lfiack/eurorack_nvlp_1u/README.md

# Eurorack NVLP 1U
Single Attack/Release envelope generator based on an STM32
