lfiack/eurorack_nvlp_1u/hardware/eurorack_nvlp_1u/eurorack_nvlp_1u.kicad_pcb

## KiCad design hardware/eurorack_nvlp_1u/eurorack_nvlp_1u.kicad_pcb (2022-10-28)

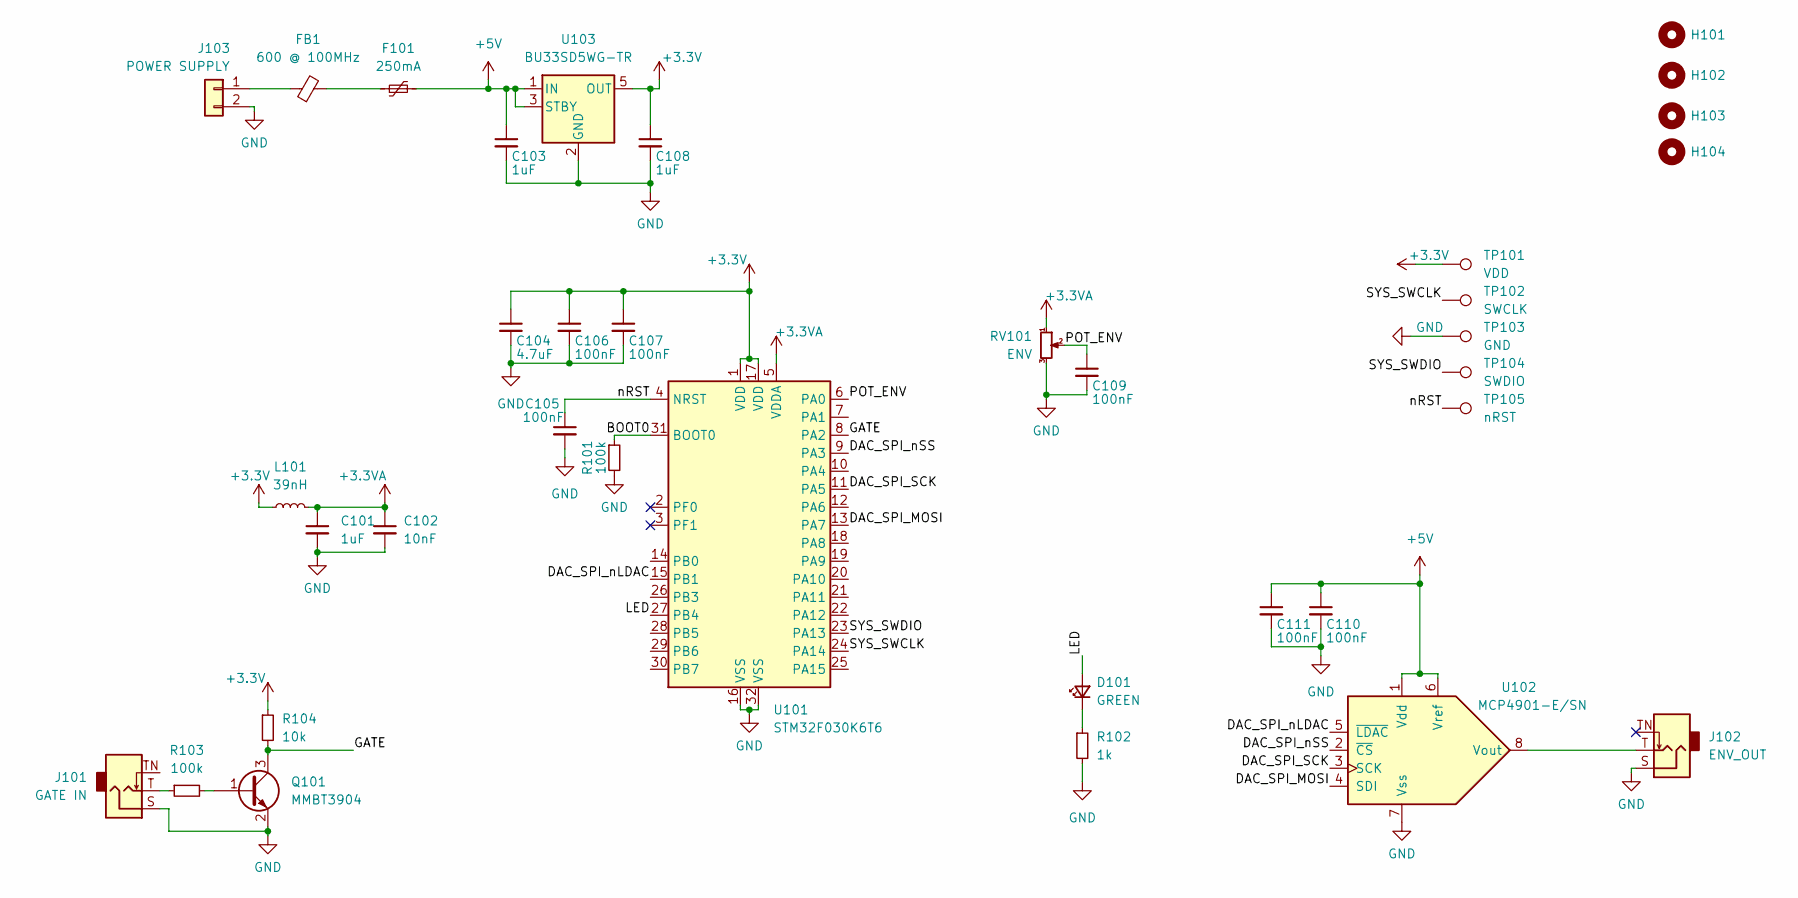
[picture p1: schematic eurorack_nvlp_1u.kicad_sch]

Parts:
C101, C103, C108: 1uF; C_0603_1608Metric
C102: 10nF; C_0603_1608Metric
C104: 4.7uF; C_0603_1608Metric
C105, C106, C107, C109, C110, C111: 100nF; C_0603_1608Metric
D101: GREEN; LED_0603_1608Metric
F101: 250mA; Fuse_1206_3216Metric; Farnell 2834880
FB1: 600 @ 100MHz; L_0805_2012Metric_Pad1.15x1.40mm_HandSolder; Farnell 2292460
H101, H102, H103, H104: MountingHole; MountingHole_3.2mm_M3
J101: GATE IN; Jack_3.5mm_QingPu_WQP-PJ398SM_Vertical_CircularHoles
J102: ENV_OUT; Jack_3.5mm_QingPu_WQP-PJ398SM_Vertical_CircularHoles
J103: POWER SUPPLY; JST_XH_B2B-XH-A_1x02_P2.50mm_Vertical
L101: 39nH; L_0603_1608Metric
Q101: MMBT3904; SOT-23
R101, R103: 100k; R_0603_1608Metric
R102: 1k; R_0603_1608Metric
R104: 10k; R_0603_1608Metric
RV101: ENV; Potentiometer_Alpha_RD901F-40-00D_Single_Vertical
TP101: VDD; TestPoint_Pad_D1.5mm
TP102: SWCLK; TestPoint_Pad_D1.5mm
TP103: GND; TestPoint_Pad_D1.5mm
TP104: SWDIO; TestPoint_Pad_D1.5mm
TP105: nRST; TestPoint_Pad_D1.5mm
U101: STM32F030K6T6; LQFP-32_7x7mm_P0.8mm
U102: MCP4901-E/SN; SOIC-8_3.9x4.9mm_P1.27mm
U103: BU33SD5WG-TR; SOT-23-5

Connections:
+3.3V: C104.1, C106.1, C107.1, C108.1, L101.1, R104.1, TP101.1, U101.1 (VDD), U101.17 (VDD), U103.5 (OUT)
+3.3VA: C101.1, C102.1, L101.2, RV101.1, U101.5 (VDDA)
+5V: C103.1, C110.1, C111.1, F101.2, U102.1 (Vdd), U102.6 (Vref), U103.1 (IN), U103.3 (STBY)
/BOOT0: R101.1, U101.31 (BOOT0)
/DAC_SPI_MOSI: U101.13 (PA7), U102.4 (SDI)
/DAC_SPI_SCK: U101.11 (PA5), U102.3 (SCK)
/DAC_SPI_nLDAC: U101.15 (PB1), U102.5 (~LDAC)
/DAC_SPI_nSS: U101.9 (PA3), U102.2 (~CS)
/GATE: Q101.3 (C), R104.2, U101.8 (PA2)
/LED: D101.2 (A), U101.27 (PB4)
/POT_ENV: C109.1, RV101.2, U101.6 (PA0)
/SYS_SWCLK: TP102.1, U101.24 (PA14)
/SYS_SWDIO: TP104.1, U101.23 (PA13)
/nRST: C105.1, TP105.1, U101.4 (NRST)
GND: C101.2, C102.2, C103.2, C104.2, C105.2, C106.2, C107.2, C108.2, C109.2, C110.2, C111.2, J101.S, J102.S, J103.2, Q101.2 (E), R101.2, R102.2, RV101.3, TP103.1, U101.16 (VSS), U101.32 (VSS), U102.7 (Vss), U103.2 (GND)
unnamed: D101.1 (K), R102.1
unnamed: F101.1, FB1.2
unnamed: J101.T, R103.1
unnamed: J102.T, U102.8 (Vout)
unnamed: FB1.1, J103.1
unnamed: Q101.1 (B), R103.2

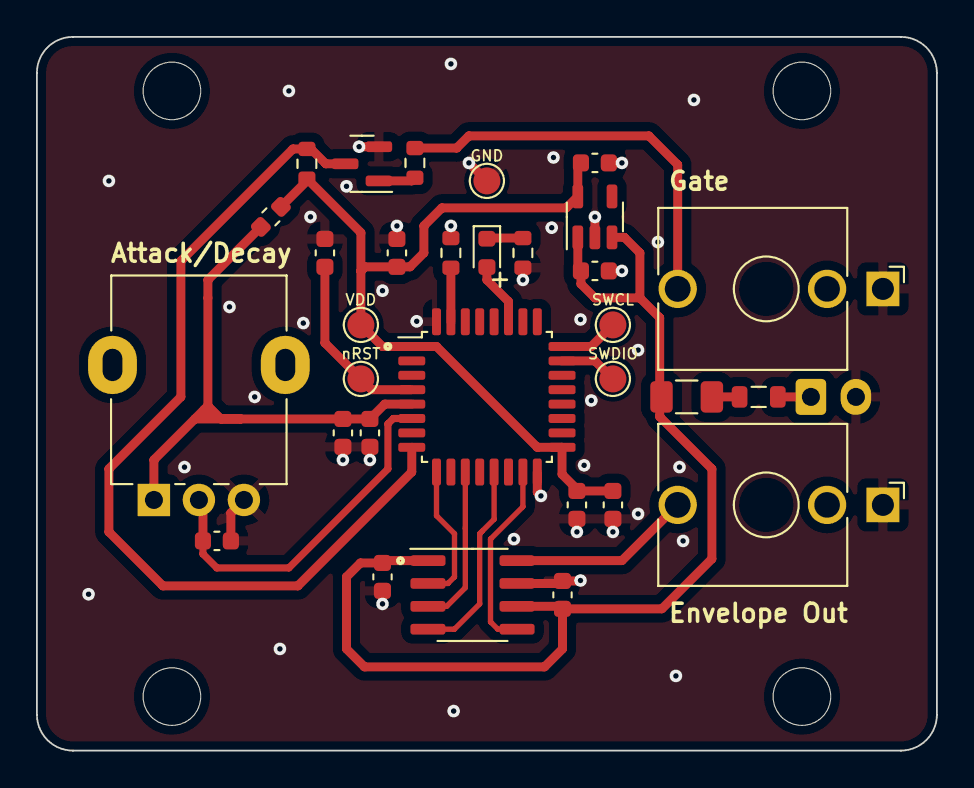
[picture p2: board eurorack_nvlp_1u.kicad_pcb from above]

Board: 2 copper layers, 50.0 x 39.6 mm, 36 parts (1 on the bottom side), 21 nets.
