lfiack/eurorack_nvlp_1u/firmware/Core/Src/main.c

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
/* Includes ------------------------------------------------------------------*/
#include "main.h"
#include "adc.h"
#include "spi.h"
#include "tim.h"
#include "gpio.h"

/* USER CODE BEGIN Includes */
#include "nvlp.h"
/* USER CODE END Includes */


/* USER CODE BEGIN PV */
h_nvlp_t h_nvlp;
nvlp_driver_t nvlp_driver;
/* USER CODE END PV */

void SystemClock_Config(void);
/* USER CODE BEGIN PFP */
uint32_t irq_counter = 0;
/* USER CODE END PFP */

/* USER CODE BEGIN 0 */
void HAL_ADC_ConvCpltCallback(ADC_HandleTypeDef* hadc)
{
  if (ADC1 == hadc->Instance)
  {
    nvlp_interrupt_callback(&h_nvlp);
    irq_counter++;
  }
}

uint8_t get_gate_pin(void)
{
  // if (GPIO_PIN_RESET == HAL_GPIO_ReadPin(GATE_GPIO_Port, GATE_Pin))
  // {
  //   return 0;
  // }
  // else
  // {
  //   return 1;
  // }

  if ((HAL_GetTick()%1000) == 0)
  {
    return 1;
  }
  else
  {
    return 0;
  }
}

uint16_t get_potentiometer(void)
{
  return (uint16_t) 65535 - HAL_ADC_GetValue(&hadc);
}

#define MCP49X1_UNBUFFERED 0
#define MCP49X1_BUFFERED 0x4000

#define MCP49X1_GAIN_0 0
#define MCP49X1_GAIN_1 0x2000

#define MCP49X1_SHDN 0
#define MCP49X1_ACTIVE 0x1000

void set_output(uint16_t value)
{
  //SPI 20MHz max (-> configured to 12MHz in CubeMX)
  //SPI supports mode 0,0 and 1,1 so CPOL=Low and CPHA=1 Edge I guess?
  //SPI is 16 bits
  //VREF in unbuffered mode (to be rail to rail 0->5V) (BUF = 0)
  //Gain is 1 (GA = 1)
  //Output activated (SHDN=1)
  //Value from bit 11 downto 0

  uint16_t command = (value >> 4) & 0x0FFF;
  command += (MCP49X1_UNBUFFERED | MCP49X1_GAIN_1 | MCP49X1_ACTIVE);

  uint8_t buffer[2] = {(command >> 8) & 0xFF, command & 0xFF};

  // Lights the LED with the full value
  __HAL_TIM_SET_COMPARE(&htim3, TIM_CHANNEL_1, value);

  HAL_GPIO_WritePin(DAC_SPI_nSS_GPIO_Port, DAC_SPI_nSS_Pin, GPIO_PIN_RESET);
  HAL_SPI_Transmit(&hspi1, buffer, 2, HAL_MAX_DELAY);
  HAL_GPIO_WritePin(DAC_SPI_nSS_GPIO_Port, DAC_SPI_nSS_Pin, GPIO_PIN_SET);
}

/* USER CODE END 0 */

/**
  * @brief  The application entry point.
  * @retval int
  */
int main(void)
{
  /* MCU Configuration--------------------------------------------------------*/

  /* Reset of all peripherals, Initializes the Flash interface and the Systick. */
  HAL_Init();

  /* Configure the system clock */
  SystemClock_Config();

  /* Initialize all configured peripherals */
  MX_GPIO_Init();
  MX_ADC_Init();
  MX_SPI1_Init();
  MX_TIM3_Init();
  MX_TIM1_Init();
  /* USER CODE BEGIN 2 */
  DBGMCU->APB2FZ |= DBGMCU_APB2_FZ_DBG_TIM1_STOP;

  HAL_ADCEx_Calibration_Start(&hadc);

  nvlp_driver.get_gate_pin = get_gate_pin;
  nvlp_driver.get_potentiometer = get_potentiometer;
  nvlp_driver.set_output = set_output;

  h_nvlp.driver = &nvlp_driver;

  h_nvlp.is_lfo = true;
  nvlp_init(&h_nvlp);

  HAL_TIM_PWM_Start(&htim3, TIM_CHANNEL_1);
  HAL_ADC_Start_IT(&hadc);
  HAL_TIM_Base_Start(&htim1);
  
  /* USER CODE END 2 */

  /* Infinite loop */
  /* USER CODE BEGIN WHILE */
  while (1)
  {
    /* USER CODE END WHILE */

    /* USER CODE BEGIN 3 */
  }
  /* USER CODE END 3 */
}

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
