lfiack/eurorack_nvlp_1u/firmware/Core/Inc/main.h

#define POT_ENV_Pin GPIO_PIN_0
#define POT_ENV_GPIO_Port GPIOA
#define GATE_Pin GPIO_PIN_2
#define GATE_GPIO_Port GPIOA
#define GATE_EXTI_IRQn EXTI2_3_IRQn
#define DAC_SPI_nSS_Pin GPIO_PIN_3
#define DAC_SPI_nSS_GPIO_Port GPIOA
#define DAC_SPI_SCK_Pin GPIO_PIN_5
#define DAC_SPI_SCK_GPIO_Port GPIOA
#define DAC_SPI_MOSI_Pin GPIO_PIN_7
#define DAC_SPI_MOSI_GPIO_Port GPIOA
#define DAC_SPI_nLDAC_Pin GPIO_PIN_1
#define DAC_SPI_nLDAC_GPIO_Port GPIOB
#define LED_Pin GPIO_PIN_4
#define LED_GPIO_Port GPIOB
