lfiack/eurorack_nvlp_1u/(commit log)

2022-10-24 Schematics + PCB
    [eurorack_nvlp_1u.kicad_pcb, eurorack_nvlp_1u.kicad_sch]
2022-10-24 small upgrades on the PCB
    [eurorack_nvlp_1u.kicad_pcb]
2022-10-28 fichiers de fab
    [eurorack_nvlp_1u-B_Cu.gbr, eurorack_nvlp_1u-B_Mask.gbr, eurorack_nvlp_1u-B_Silkscreen.gbr, eurorack_nvlp_1u-Edge_Cuts.gbr, eurorack_nvlp_1u-F_Cu.gbr, eurorack_nvlp_1u-F_Mask.gbr, eurorack_nvlp_1u-F_Silkscreen.gbr, eurorack_nvlp_1u-NPTH.drl]
2022-11-23 fixed ADC configuration
2022-11-23 corrected SPI driver
